arjunvs626/hapsole/Kicad/hapsole.kicad_pcb

## KiCad design Kicad/hapsole.kicad_pcb (2025-09-12)

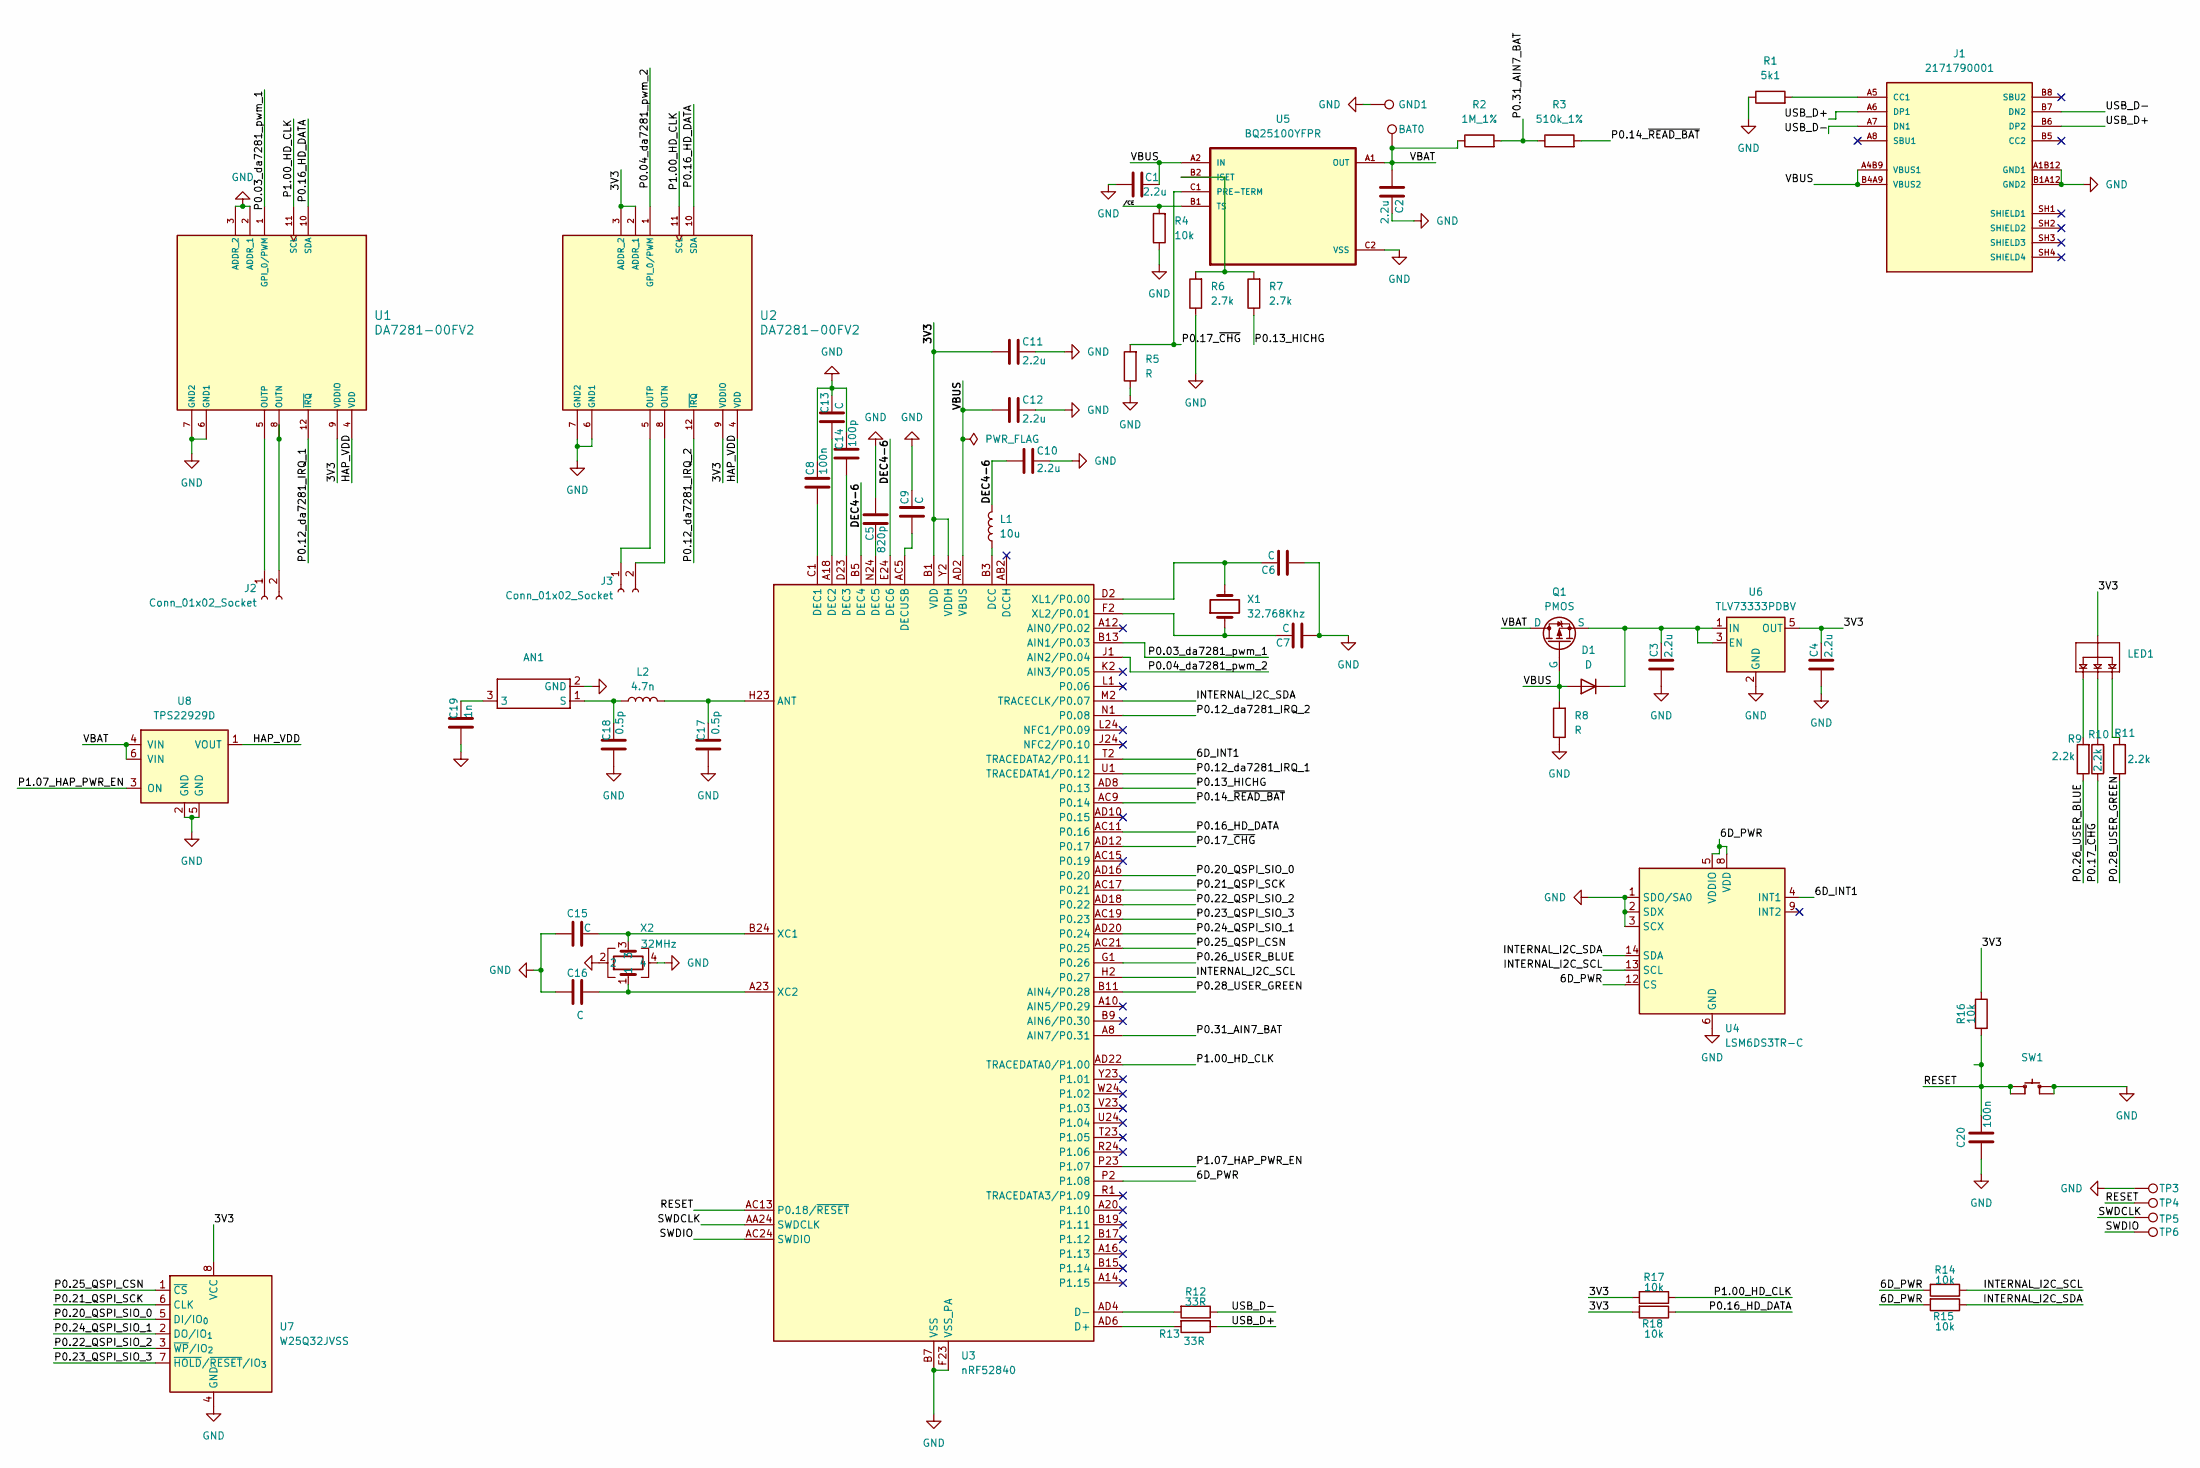
[picture p1: schematic hapsole.kicad_sch, Hapsole_Smart_Device]

Parts:
AN1: ANT
C1, C2, C3, C4, C10, C11, C12: 2.2u; C_0201_0603Metric
C5: 820p; C_0201_0603Metric
C6, C7, C9, C13, C15, C16: C; C_0201_0603Metric
C8, C20: 100n; C_0201_0603Metric
C14: 100p; C_0201_0603Metric
C17, C18: 0.5p; C_0201_0603Metric
C19: 1n; C_0201_0603Metric
D1: D; D_0603_1608Metric
J1: 2171790001; MOLEX_2171790001; PARTREV A1; DigiKey_Part_Number 900-2171790001CT-ND
J2, J3: Conn_01x02_Socket; JST_S2B-ZR-SM4A-TF
L1: 10u; L_0402_1005Metric
L2: 4.7n; L_0402_1005Metric
LED1: RGB_LED
Q1: PMOS; SOT-883
R1: 5k1; R_0201_0603Metric
R2: 1M_1%; R_0201_0603Metric
R3: 510k_1%; R_0201_0603Metric
R4, R14, R15, R16, R17, R18: 10k; R_0201_0603Metric
R5, R8: R; R_0201_0603Metric
R6, R7: 2.7k; R_0201_0603Metric
R9, R10, R11: 2.2k; R_0201_0603Metric
R12, R13: 33R; R_0201_0603Metric
SW1: DPST
TP1: BAT0; TestPoint_Pad_D1.5mm
TP2: GND1; TestPoint_Pad_D1.5mm
TP3, TP4, TP5, TP6: TestPoint; TestPoint_Pad_1.0x1.0mm
U1, U2: DA7281-00FV2; DA7281-00FV2_DIL
U3: nRF52840; Nordic_AQFN-73-1EP_7x7mm_P0.5mm
U4: LSM6DS3TR-C; LGA-14_3x2.5mm_P0.5mm_LayoutBorder3x4y
U5: BQ25100YFPR; BGA6N40P3X2_157X88X50N
U6: TLV73333PDBV; SOT-23-5
U7: W25Q32JVSS; Untitled
U8: TPS22929D; SOT-23-6
X1: 32.768Khz; FC135
X2: 32MHz; XC

Connections:
/3V3: C4.2, C11.1, LED1.+, R16.1, R17.2, R18.2, U1.9 (VDDIO), U2.2 (ADDR_1), U2.3 (ADDR_2), U2.9 (VDDIO), U3.A22 (VDD), U3.AD14 (VDD), U3.AD23 (VDD), U3.B1 (VDD), U3.W1 (VDD), U3.Y2 (VDDH), U6.5 (OUT), U7.8 (VCC)
/6D_INT1: U3.T2 (TRACEDATA2/P0.11), U4.4 (INT1)
/6D_PWR: R14.2, R15.2, U3.P2 (P1.08), U4.5 (VDDIO), U4.8 (VDD), U4.12 (CS)
/DEC4-6: C10.1, L1.2, U3.B5 (DEC4), U3.E24 (DEC6)
/HAP_VDD: U1.4 (VDD), U2.4 (VDD), U8.1 (VOUT)
/INTERNAL_I2C_SCL: R14.1, U3.H2 (P0.27), U4.13 (SCL)
/INTERNAL_I2C_SDA: R15.1, U3.M2 (TRACECLK/P0.07), U4.14 (SDA)
/P0.03_da7281_pwm_1: U1.1 (GPI_0/PWM), U3.B13 (AIN1/P0.03)
/P0.04_da7281_pwm_2: U2.1 (GPI_0/PWM), U3.J1 (AIN2/P0.04)
/P0.12_da7281_IRQ_1: U1.12 (~IRQ), U3.U1 (TRACEDATA1/P0.12)
/P0.12_da7281_IRQ_2: U2.12 (~IRQ), U3.N1 (P0.08)
/P0.13_HICHG: R7.1, U3.AD8 (P0.13)
/P0.14_~READ_BAT: R3.2, U3.AC9 (P0.14)
/P0.16_HD_DATA: R18.1, U1.10 (SDA), U2.10 (SDA), U3.AC11 (P0.16)
/P0.17_~CHG: R5.2, R10.1, U3.AD12 (P0.17), U5.C1 (PRE-TERM)
/P0.20_QSPI_SIO_0: U3.AD16 (P0.20), U7.5 (DI/IO_{0})
/P0.21_QSPI_SCK: U3.AC17 (P0.21), U7.6 (CLK)
/P0.22_QSPI_SIO_2: U3.AD18 (P0.22), U7.3 (~WP/IO_{2})
/P0.23_QSPI_SIO_3: U3.AC19 (P0.23), U7.7 (~HOLD/~RESET/IO_{3})
/P0.24_QSPI_SIO_1: U3.AD20 (P0.24), U7.2 (DO/IO_{1})
/P0.25_QSPI_CSN: U3.AC21 (P0.25), U7.1 (~CS)
/P0.26_USER_BLUE: R9.1, U3.G1 (P0.26)
/P0.28_USER_GREEN: R11.1, U3.B11 (AIN4/P0.28)
/P0.31_AIN7_BAT: R2.2, R3.1, U3.A8 (AIN7/P0.31)
/P1.00_HD_CLK: R17.1, U1.11 (SCL), U2.11 (SCL), U3.AD22 (TRACEDATA0/P1.00)
/P1.07_HAP_PWR_EN: U3.P23 (P1.07), U8.3 (ON)
/RESET: C20.1, R16.2, SW1.1 (A0), SW1.3 (A1), TP4.1, U3.AC13 (P0.18/~RESET)
/SWDCLK: TP5.1, U3.AA24 (SWDCLK)
/SWDIO: TP6.1, U3.AC24 (SWDIO)
/USB_D+: J1.A6 (DP1), J1.B6 (DP2), R13.1
/USB_D-: J1.A7 (DN1), J1.B7 (DN2), R12.1
/VBAT: C2.1, Q1.1 (D), R2.1, TP1.1, U5.A1 (OUT), U8.4 (VIN), U8.6 (VIN)
/VBUS: C1.2, C12.1, D1.2 (A), J1.A4B9 (VBUS1), J1.B4A9 (VBUS2), Q1.2 (G), R8.2, U3.AD2 (VBUS), U5.A2 (IN)
//CE: R4.2, U5.B1 (TS)
GND: AN1.2 (GND), C1.1, C2.2, C3.1, C4.1, C5.2, C6.1, C7.1, C8.2, C9.2, C10.2, C11.2, C12.2, C13.2, C14.2, C15.2, C16.2, C17.1, C18.1, C19.1, C20.2, J1.A1B12 (GND1), J1.B1A12 (GND2), R1.1, R4.1, R5.1, R6.1, R8.1, SW1.2 (B0), SW1.4 (B1), TP2.1, TP3.1, U1.2 (ADDR_1), U1.3 (ADDR_2), U1.6 (GND1), U1.7 (GND2), U2.6 (GND1), U2.7 (GND2), U3.B7 (VSS), U3.EP (VSS), U3.F23 (VSS_PA), U4.1 (SDO/SA0), U4.2 (SDX), U4.3 (SCX), U4.6 (GND), U4.7 (GND), U5.C2 (VSS), U6.2 (GND), U7.4 (GND), U8.2 (GND), U8.5 (GND), X2.2, X2.4
unnamed: AN1.3, C19.2
unnamed: AN1.1 (S), C18.2, L2.1
unnamed: C3.2, D1.1 (K), Q1.3 (S), U6.1 (IN), U6.3 (EN)
unnamed: J1.A5 (CC1), R1.2
unnamed: J2.1, U1.5 (OUTP)
unnamed: J2.2, U1.8 (OUTN)
unnamed: J3.1, U2.5 (OUTP)
unnamed: J3.2, U2.8 (OUTN)
unnamed: LED1.B-, R9.2
unnamed: LED1.G-, R10.2
unnamed: LED1.R-, R11.2
unnamed: C17.2, L2.2, U3.H23 (ANT)
unnamed: R13.2, U3.AD6 (D+)
unnamed: R12.2, U3.AD4 (D-)
unnamed: L1.1, U3.B3 (DCC)
unnamed: C8.1, U3.C1 (DEC1)
unnamed: C13.1, U3.A18 (DEC2)
unnamed: C14.1, U3.D23 (DEC3)
unnamed: C5.1, U3.N24 (DEC5)
unnamed: C9.1, U3.AC5 (DECUSB)
unnamed: C15.1, U3.B24 (XC1), X2.3
unnamed: C16.1, U3.A23 (XC2), X2.1
unnamed: C6.2, U3.D2 (XL1/P0.00), X1.2
unnamed: C7.2, U3.F2 (XL2/P0.01), X1.1
unnamed: R6.2, R7.2, U5.B2 (ISET)

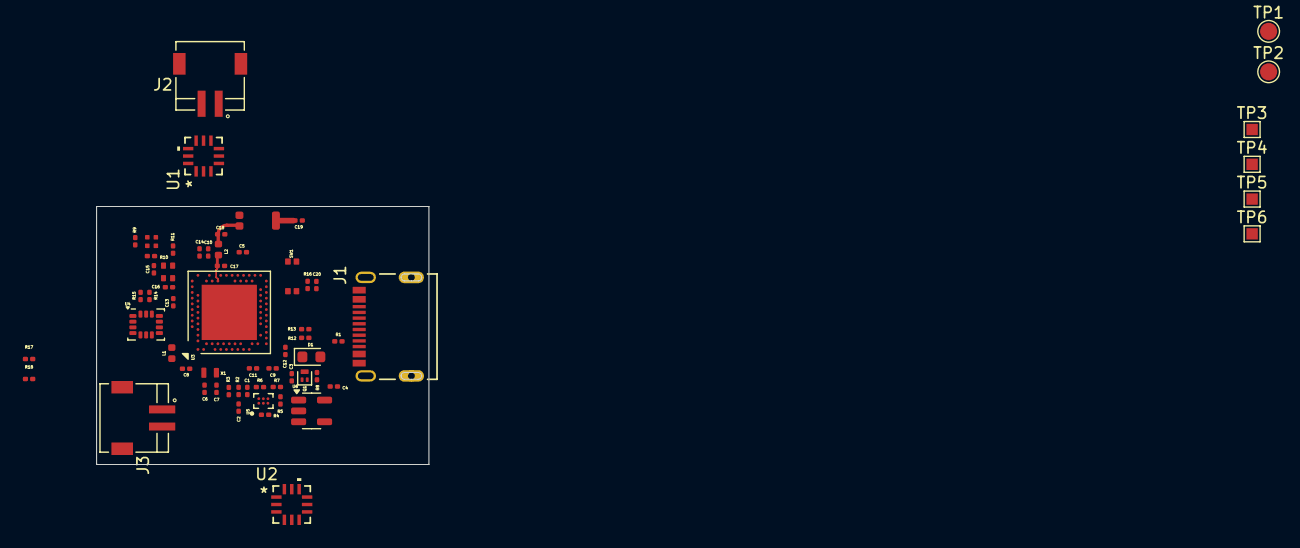
[picture p2: board hapsole.kicad_pcb from above]

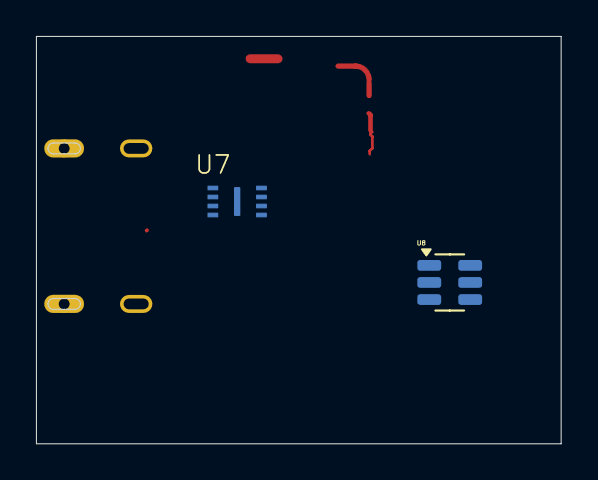
[picture p3: board hapsole.kicad_pcb from below]

Board: 4 copper layers, 29.2 x 22.6 mm, 64 parts (2 on the bottom side), 60 nets.
