arjunvs626/hapsole/(commit log)

2025-08-07 Intitial Commit for Kicad Project
    [hapsole.kicad_pcb, hapsole.kicad_sch]
2025-08-07 Added the crystal
    [hapsole.kicad_sch]
2025-08-07 same commit
    [hapsole.kicad_pcb, hapsole.kicad_sch]
2025-08-07 Added i2c Pins
    [hapsole.kicad_sch]
2025-08-13 added da7281
    [hapsole.kicad_sch]
2025-08-14 Added Footprints of R,C
    [hapsole.kicad_sch]
2025-08-18 initiated the PCB design
    [hapsole.kicad_pcb, hapsole.kicad_sch]
2025-08-28 placed the components in PCB & started routing
    [hapsole.kicad_pcb, hapsole.kicad_sch]
2025-08-28 added library
    [hapsole.kicad_pcb, hapsole.kicad_sch]
2025-08-29 Resized and rearranged components placement
    [hapsole.kicad_pcb, hapsole.kicad_sch]
2025-09-09 Deleted the pcb design and start from the scratch
    [hapsole.kicad_pcb, hapsole.kicad_sch]
2025-09-11 Arranged the components
    [hapsole.kicad_pcb]
2025-09-12 finished arrangement of all components
    [hapsole.kicad_pcb, hapsole.kicad_sch]
